Jacksurfer2005/TKHTN/Docs/REPORT/chap/chap6.tex

\section{TÀI LIỆU THAM KHẢO}
\begin{enumerate}
    \item Atmel, ATmega328P 8-bit AVR Microcontroller with 32K Bytes In-System Programmable Flash DATASHEET, \href{https://ww1.microchip.com/downloads/en/DeviceDoc/Atmel-7810-Automotive-Microcontrollers-ATmega328P_Datasheet.pdf}{ATmega328p.pdf}
    \item HITACHI, HD44780U (LCD-II) Datasheet. \href{https://cdn.sparkfun.com/assets/9/5/f/7/b/HD44780.pdf}{LCD1602.pdf}
    \item Maxim Integrated, MAX7219/MAX7221 Datasheet, \href{https://www.analog.com/media/en/technical-documentation/data-sheets/MAX7219-MAX7221.pdf}{MAX7219.pdf}
    \item NanJing Top Power ASIC Corp., TP4056 1A Standalone Linear Li-lon Battery Charger Datasheet. \href{https://dlnmh9ip6v2uc.cloudfront.net/datasheets/Prototyping/TP4056.pdf}{TP4056.pdf}
    \item Aerosemi MT3608 High Efficiency 1.2MHz 2A Step Up Converter Datasheet. \href{https://www.olimex.com/Products/Breadboarding/BB-PWR-3608/resources/MT3608.pdf}{MT3608.pdf}
\end{enumerate}
