Jacksurfer2005/TKHTN/Docs/REPORT/img/LCD.png

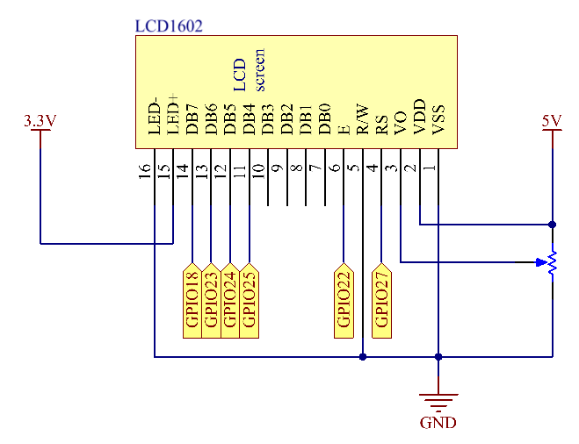
Docs/REPORT/img/LCD.png
