Jacksurfer2005/TKHTN/Docs/REPORT/img/main_struct.png

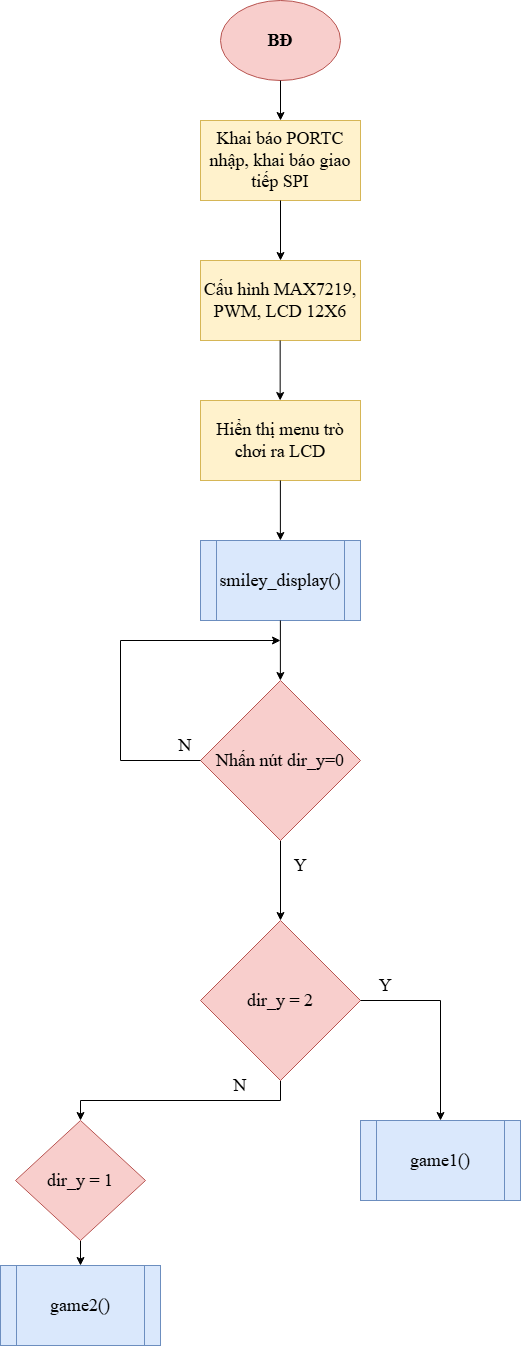
Docs/REPORT/img/main_struct.png
