Jacksurfer2005/TKHTN/Docs/REPORT/img/SCHEM_LEDMATRX.png

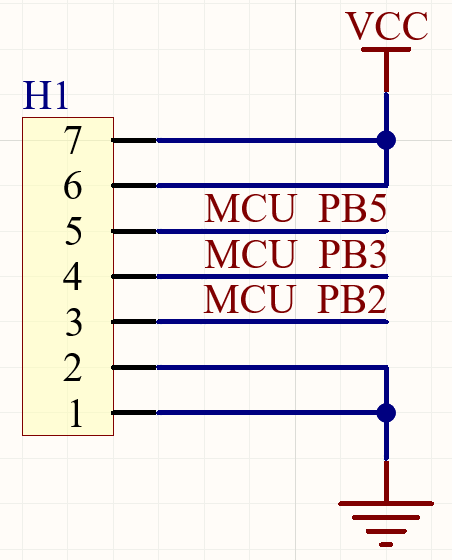
Docs/REPORT/img/SCHEM_LEDMATRX.png
