Jacksurfer2005/TKHTN/Hardware/1.pdf

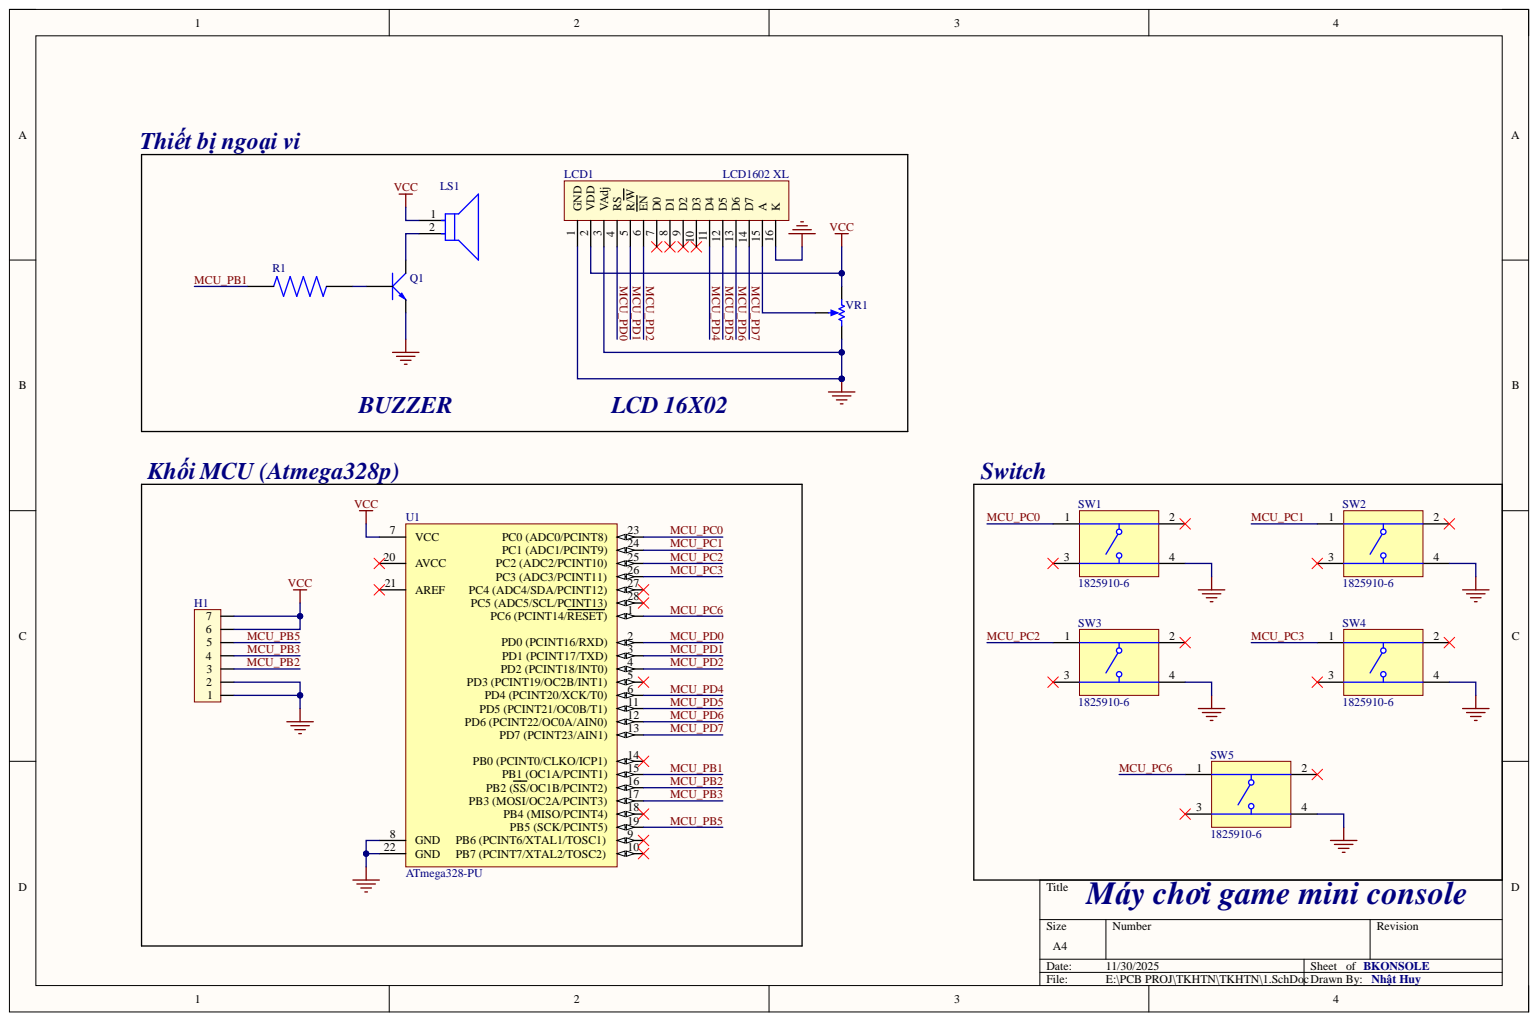
[picture p27: page 1]

Thiết bị ngoại vi

Máy chơi game mini console
