Jacksurfer2005/TKHTN/Hardware/TKHTN.pdf

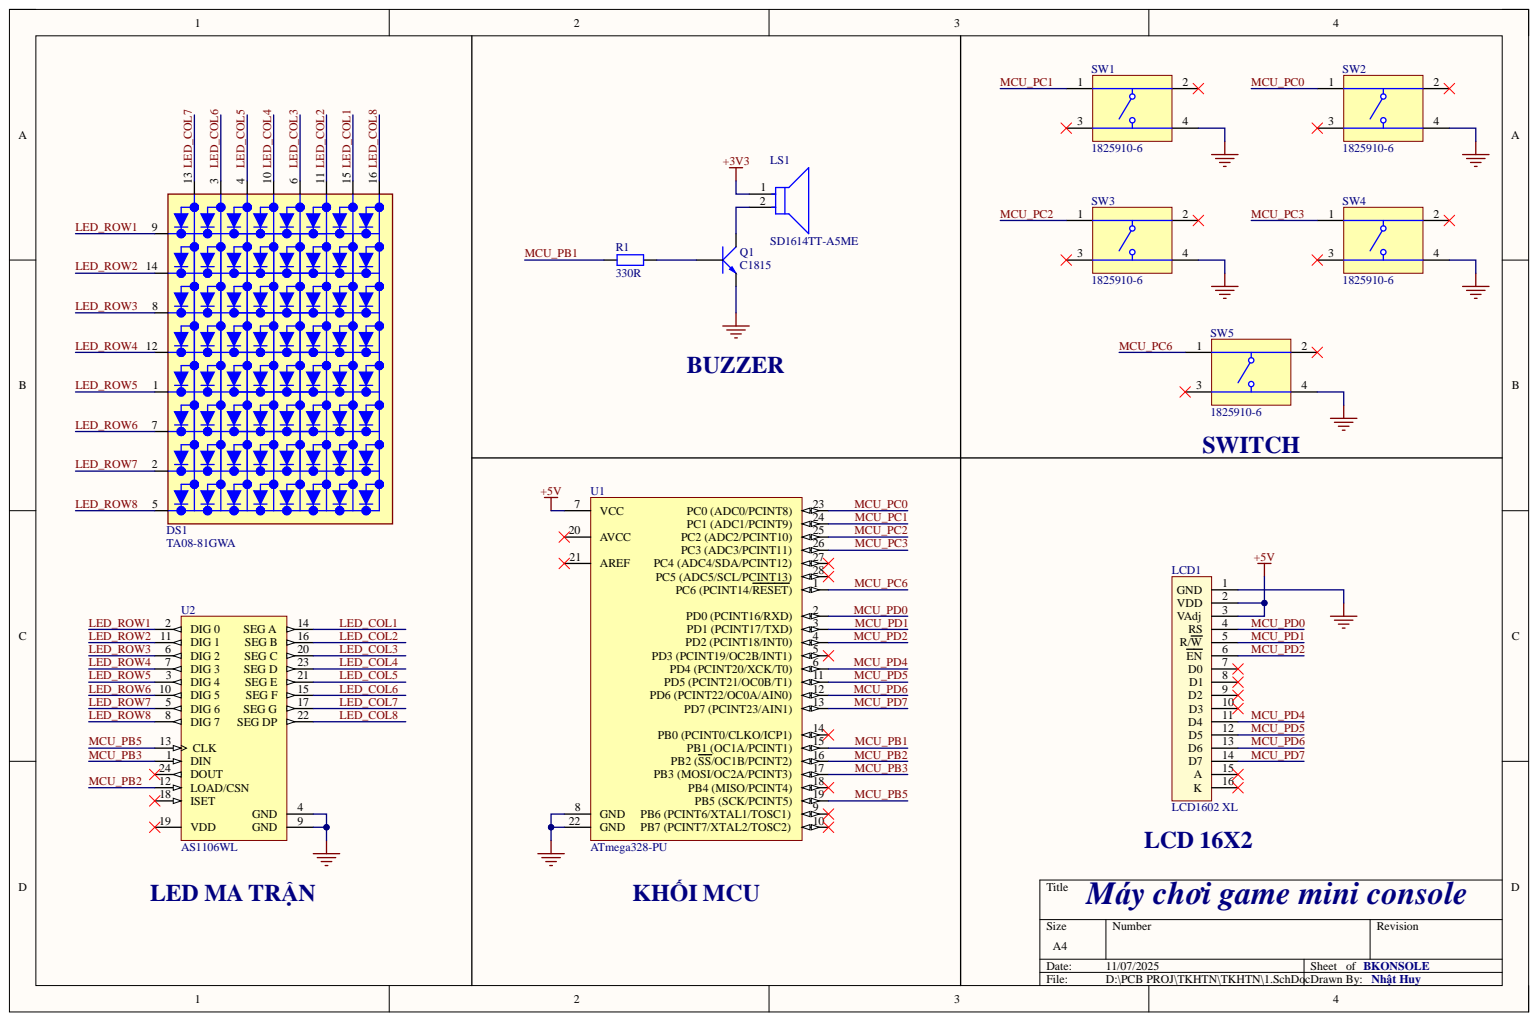
[picture p28: page 1]
