Jacksurfer2005/TKHTN/(list of files, drawings)

Other design files:
design.pdsprj
Hardware/1.PcbDoc
Hardware/1.SchDoc
Hardware/Schlib1.SchLib
Hardware/TKHTN.PrjPcb
TEST.pdsprj
