Jacksurfer2005/TKHTN/Firmware/inc/display_led.h

/*
 * display_led.h
 *
 * Created: 10/4/2025 10:19:25 PM
 *  Author: DELL
 */ 


#ifndef DISPLAY_LED_H_
#define DISPLAY_LED_H_

#include "config.h"
#include "draw_led.h"
void display_led(void);
void display_led2(void);
void blink_display(void);
void smiley_display(void);
void sad_display(void);

#endif /* DISPLAY_LED_H_ */
