Jacksurfer2005/TKHTN/Firmware/inc/max_init.h

/*
 * max_init.h
 *
 * Created: 10/4/2025 9:51:24 PM
 *  Author: DELL
 */ 


#ifndef MAX_INIT_H_
#define MAX_INIT_H_

#include "config.h"
#include "max7219_send.h"
void MAX7219_Init(void);


#endif /* MAX_INIT_H_ */
