Jacksurfer2005/TKHTN/Firmware/inc/mini_game.h

/*
 * mini_game.h
 *
 * Created: 10/4/2025 10:18:35 PM
 *  Author: DELL
 */ 


#ifndef MINI_GAME_H_
#define MINI_GAME_H_

#include "config.h"
#include "buzzer.h"
#include "buzzer.h"
#include "display_led.h"
void spawnFood(void);
uint8_t checkCollision(Point head);
void moveSnake(void);


#endif /* MINI_GAME_H_ */
