Jacksurfer2005/TKHTN/(commit log)

2025-09-28 Update and rename #define F_CPU 16000000UL.txt to snake_code
2026-04-07 Hardware init
    [1.PcbDoc, 1.SchDoc, Schlib1.SchLib, TKHTN.PrjPcb]
2026-04-07 Thêm đầy đủ folder Hardware, Firmware và báo cáo PDF
